hhhug000/HexaMouse/newpcb/HexaMouse.kicad_pcb

## KiCad design newpcb/HexaMouse.kicad_pcb (2026-09-28)

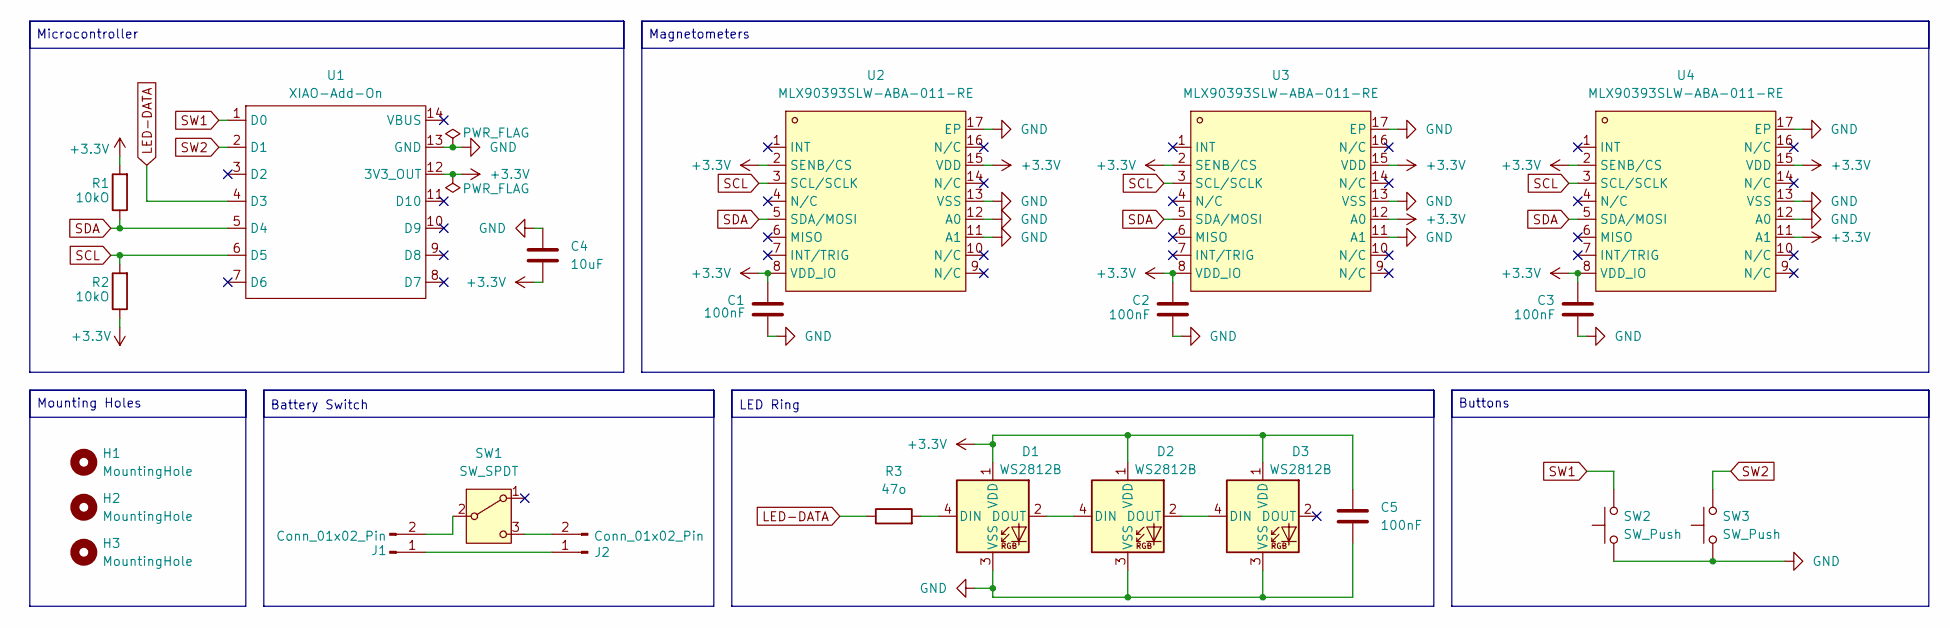
[picture p1: schematic HexaMouse.kicad_sch]

Parts:
C1, C2, C3, C5: 100nF; C_0603_1608Metric; LCSC C14663
C4: 10uF; C_0603_1608Metric; LCSC C96446
D1, D2, D3: WS2812B; LED_WS2812B_PLCC4_5.0x5.0mm_P3.2mm; LCSC C2761795
H1, H2, H3: MountingHole; MountingHole_3.2mm_M3
J1, J2: Conn_01x02_Pin; PinHeader_1x02_P2.54mm_Vertical
R1, R2: 10kO; R_0603_1608Metric; LCSC C25804
R3: 47o; R_0603_1608Metric; LCSC C23182
SW1: SW_SPDT; SW_SPDT_PCM12; LCSC C221841
SW2, SW3: SW_Push; SW_SPST_B3U-3000P-B; LCSC C4364471
U1: XIAO-Add-On; XIAO-14P-Add-On
U2, U3, U4: MLX90393SLW-ABA-011-RE; VQFN-16_L3.0-W3.0-P0.50-BL-EP1.7; MPN MLX90393SLW-ABA-011-RE; LCSC Part C2649492

Connections:
+3.3V: C1.1, C2.1, C3.1, C4.2, C5.1, D1.1 (VDD), D2.1 (VDD), D3.1 (VDD), R1.2, R2.1, U1.12 (3V3_OUT), U2.2 (SENB/CS), U2.8 (VDD_IO), U2.15 (VDD), U3.2 (SENB/CS), U3.8 (VDD_IO), U3.12 (A0), U3.15 (VDD), U4.2 (SENB/CS), U4.8 (VDD_IO), U4.11 (A1), U4.15 (VDD)
GND: C1.2, C2.2, C3.2, C4.1, C5.2, D1.3 (VSS), D2.3 (VSS), D3.3 (VSS), SW2.1, SW3.1, U1.13 (GND), U2.11 (A1), U2.12 (A0), U2.13 (VSS), U2.17 (EP), U3.11 (A1), U3.13 (VSS), U3.17 (EP), U4.12 (A0), U4.13 (VSS), U4.17 (EP)
LED-DATA: R3.1, U1.4 (D3)
unnamed: D1.4 (DIN), R3.2
unnamed: D1.2 (DOUT), D2.4 (DIN)
unnamed: D2.2 (DOUT), D3.4 (DIN)
unnamed: J1.1, J2.1
unnamed: J1.2, SW1.2 (B)
unnamed: J2.2, SW1.3 (C)
SCL: R2.2, U1.6 (D5), U2.3 (SCL/SCLK), U3.3 (SCL/SCLK), U4.3 (SCL/SCLK)
SDA: R1.1, U1.5 (D4), U2.5 (SDA/MOSI), U3.5 (SDA/MOSI), U4.5 (SDA/MOSI)
SW1: SW2.2, U1.1 (D0)
SW2: SW3.2, U1.2 (D1)

Notes on the sheet:
LED Ring
Battery Switch
Mounting Holes
Magnetometers
Buttons
Microcontroller

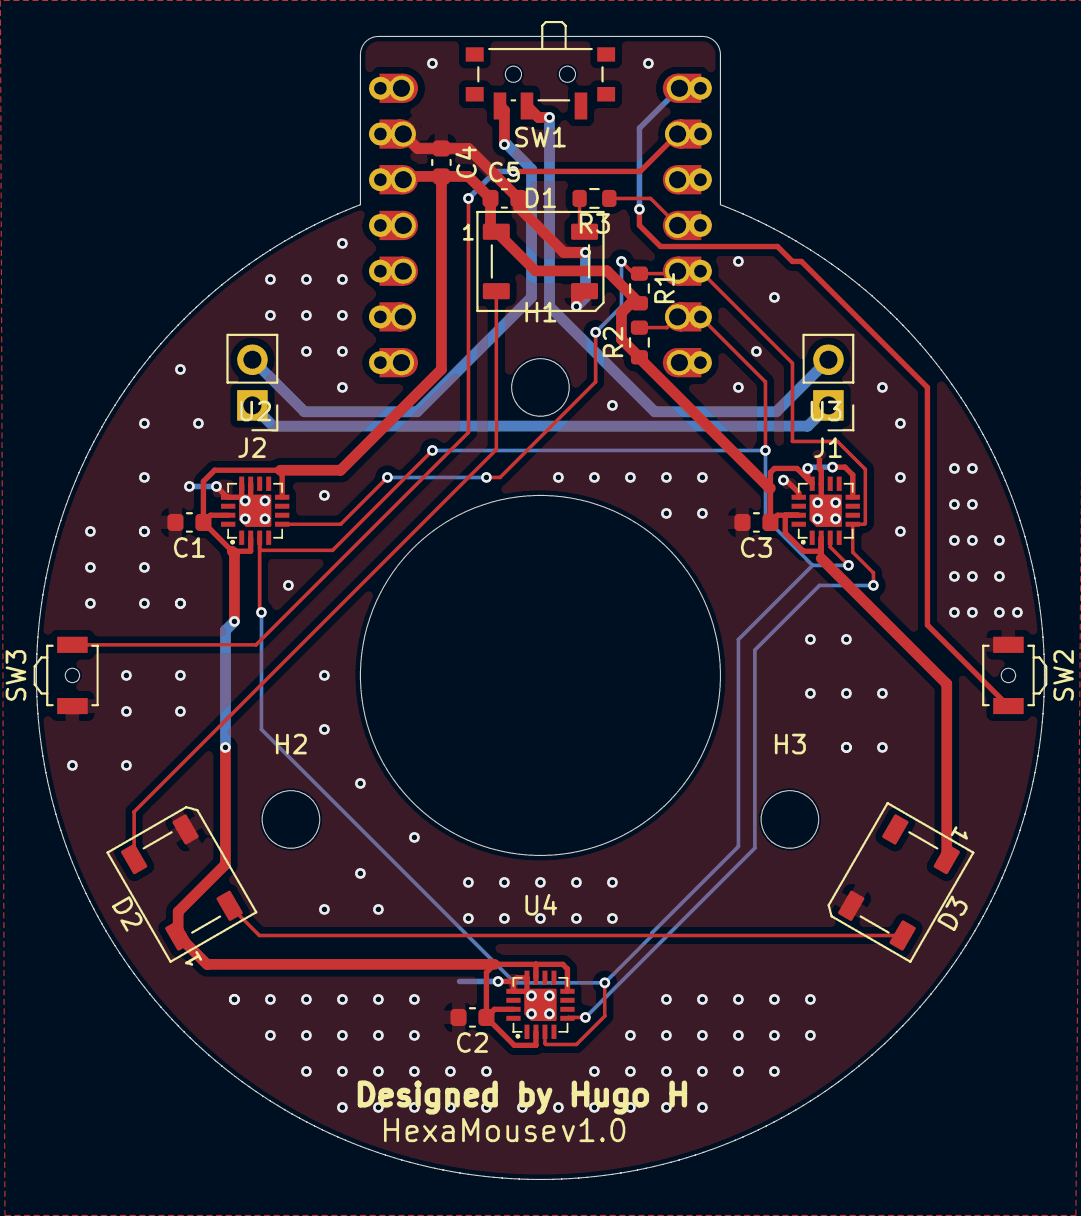
[picture p2: board newpcb/HexaMouse.kicad_pcb from above]

Board: 2 copper layers, 56.0 x 63.5 mm, 23 parts (1 on the bottom side), 13 nets.
