hhhug000/HexaMouse/pcb/HexaMouse.kicad_pcb

## KiCad design pcb/HexaMouse.kicad_pcb (2026-09-26)

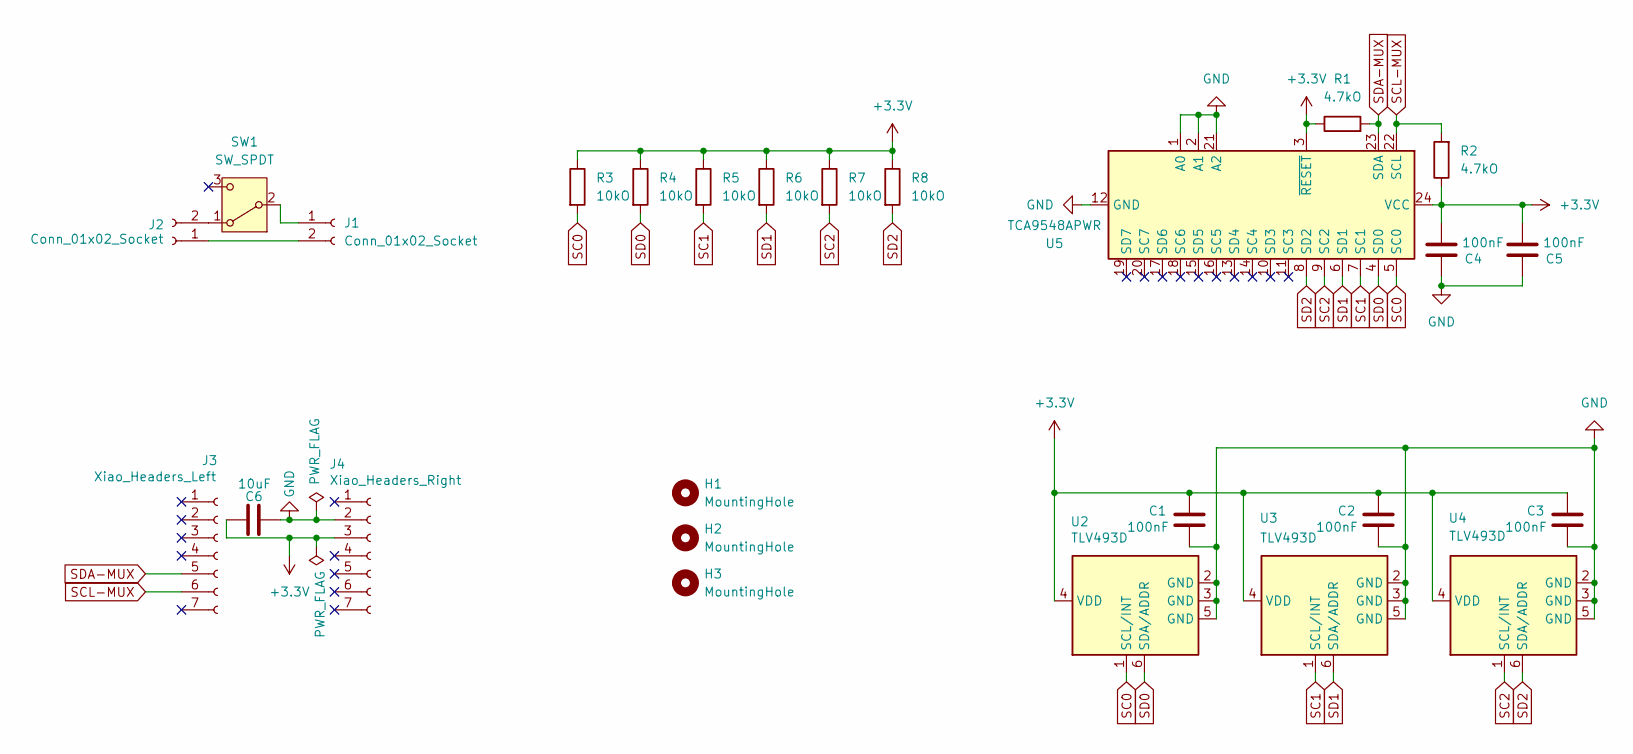
[picture p3: schematic HexaMouse.kicad_sch]

Parts:
C1, C2, C3, C4, C5: 100nF; C_0805_2012Metric; LCSC C1711
C6: 10uF; C_0805_2012Metric; LCSC C15850
H1, H2, H3: MountingHole; MountingHole_3.2mm_M3
J1, J2: Conn_01x02_Socket; JST_SH_SM02B-SRSS-TB_1x02-1MP_P1.00mm_Horizontal; LCSC C160402
J3: Xiao_Headers_Left; PinSocket_1x07_P2.54mm_Vertical_SMD_Pin1Left; LCSC C42379199
J4: Xiao_Headers_Right; PinSocket_1x07_P2.54mm_Vertical_SMD_Pin1Right; LCSC C42379199
R1, R2: 4.7kO; R_0805_2012Metric; LCSC C17673
R3, R4, R5, R6, R7, R8: 10kO; R_0805_2012Metric; LCSC C17414
SW1: SW_SPDT; SW_SPDT_PCM12; LCSC C221841
U2, U3, U4: TLV493D; SOT-23-6; LCSC C126688
U5: TCA9548APWR; TSSOP-24_4.4x7.8mm_P0.65mm; LCSC C130026

Connections:
+3.3V: C1.1, C2.1, C3.1, C4.2, C5.2, C6.2, J4.3, R1.1, R2.1, R3.1, R4.1, R5.1, R6.1, R7.1, R8.1, U2.4 (VDD), U3.4 (VDD), U4.4 (VDD), U5.3 (~RESET), U5.24 (VCC)
GND: C1.2, C2.2, C3.2, C4.1, C5.1, C6.1, J4.2, U2.2 (GND), U2.3 (GND), U2.5 (GND), U3.2 (GND), U3.3 (GND), U3.5 (GND), U4.2 (GND), U4.3 (GND), U4.5 (GND), U5.1 (A0), U5.2 (A1), U5.12 (GND), U5.21 (A2)
unnamed: J1.1, SW1.2 (B)
unnamed: J1.2, J2.1
unnamed: J2.2, SW1.1 (A)
SC0: R3.2, U2.1 (SCL/INT), U5.5 (SC0)
SC1: R5.2, U3.1 (SCL/INT), U5.7 (SC1)
SC2: R7.2, U4.1 (SCL/INT), U5.9 (SC2)
SCL-MUX: J3.6, R2.2, U5.22 (SCL)
SD0: R4.2, U2.6 (SDA/ADDR), U5.4 (SD0)
SD1: R6.2, U3.6 (SDA/ADDR), U5.6 (SD1)
SD2: R8.2, U4.6 (SDA/ADDR), U5.8 (SD2)
SDA-MUX: J3.5, R1.2, U5.23 (SDA)

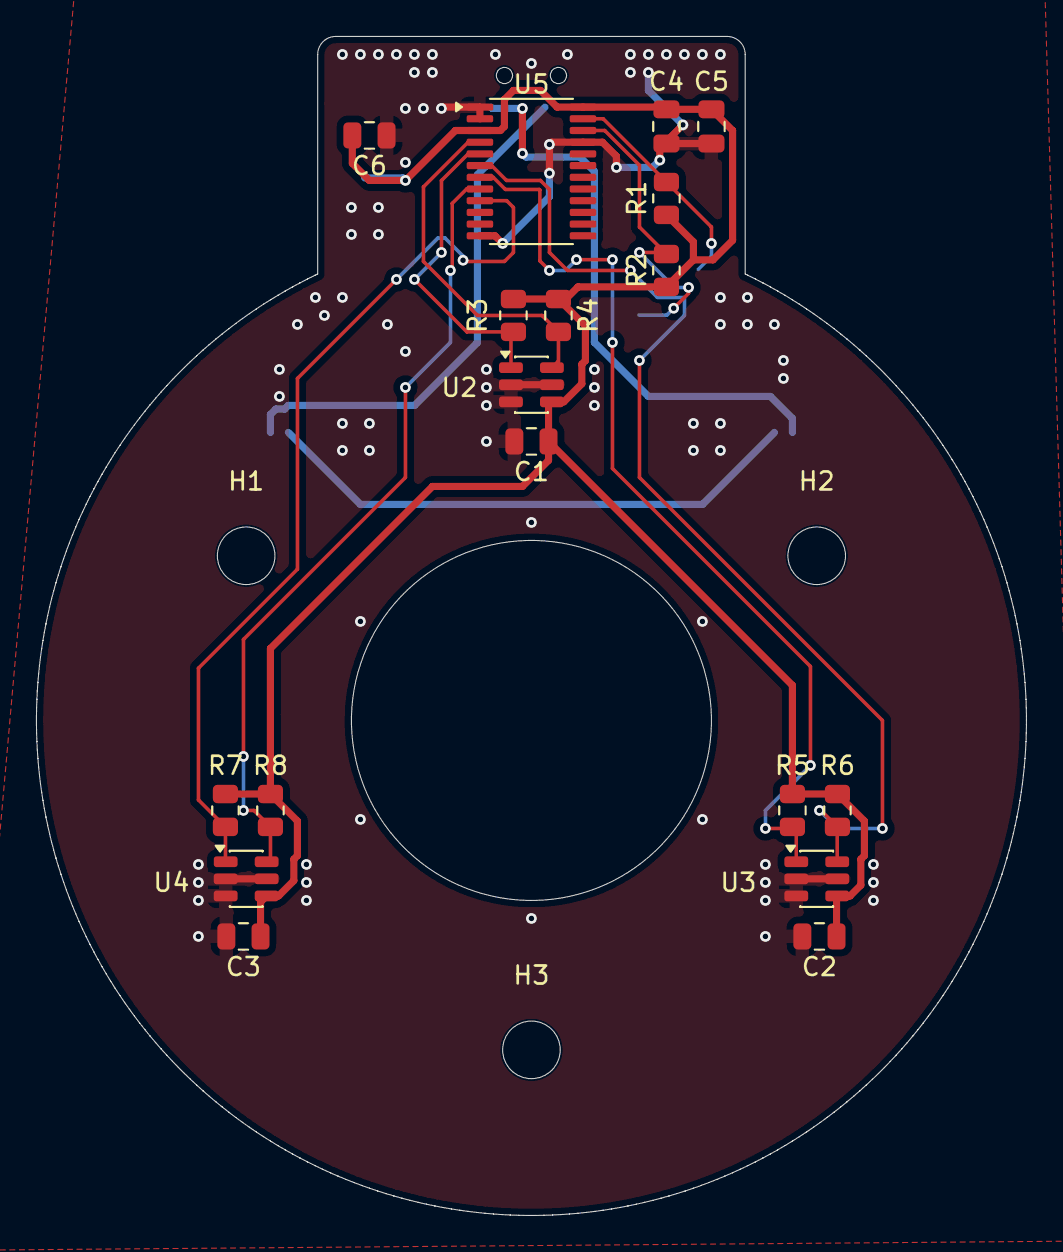
[picture p4: board pcb/HexaMouse.kicad_pcb from above]

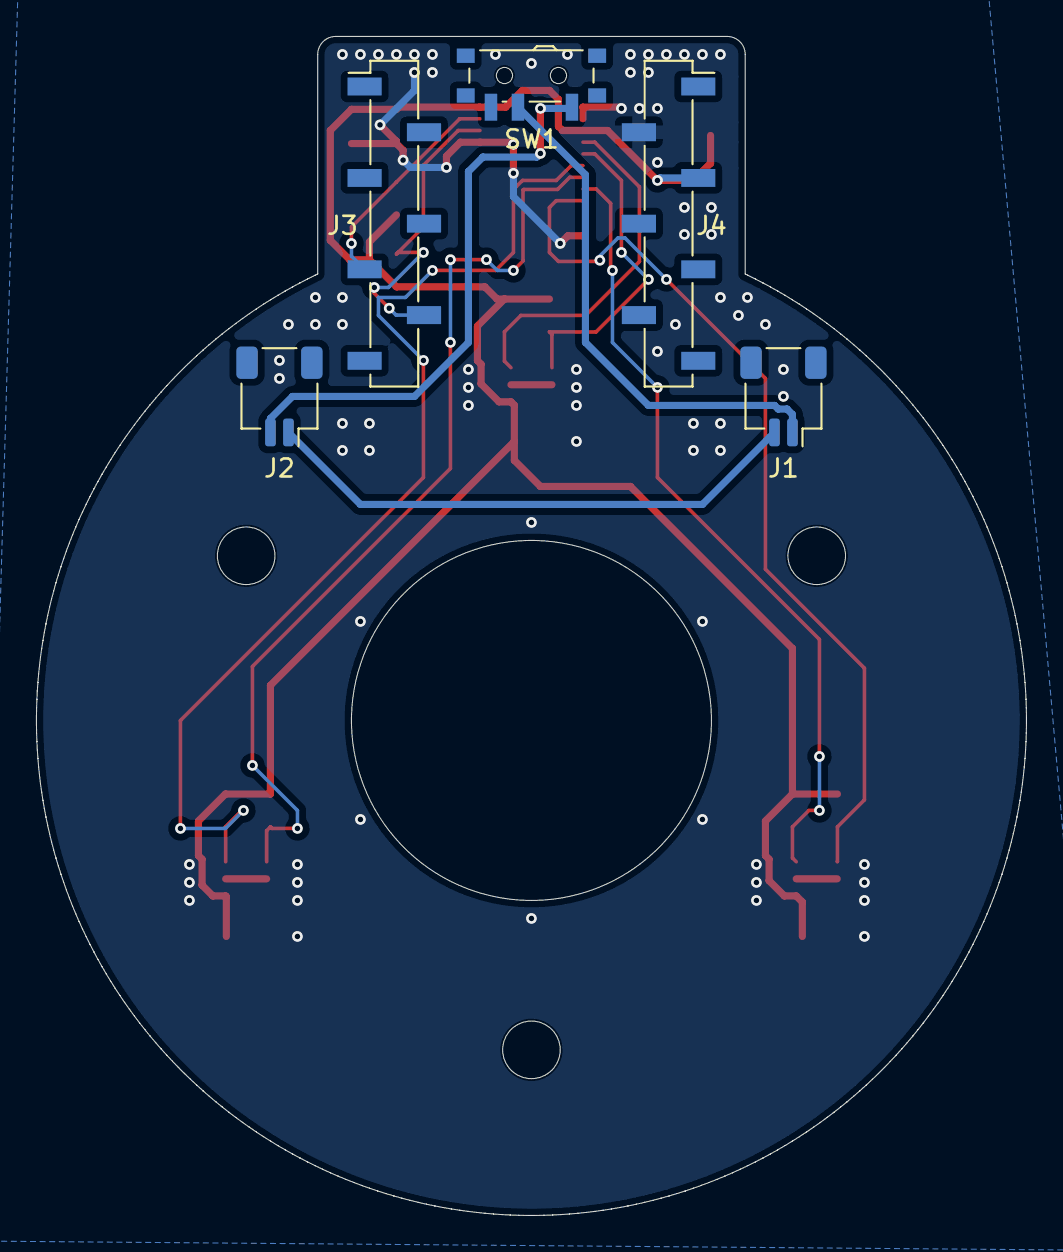
[picture p5: board pcb/HexaMouse.kicad_pcb from below]

Board: 2 copper layers, 55.0 x 65.5 mm, 26 parts (5 on the bottom side), 13 nets.
