hhhug000/HexaMouse/(commit log)

2026-09-19 Add kicad project and seeed studio xiao libs
    [HexaMouse.kicad_pcb, HexaMouse.kicad_sch]
2026-09-19 Added microcontroller board to schematic
    [HexaMouse.kicad_sch]
2026-09-19 magnetometers + i2c mux added to schematic
    [HexaMouse.kicad_sch]
2026-09-19 Added supporting hardware
    [HexaMouse.kicad_sch]
2026-09-20 Added more power caps and no connect flags
    [HexaMouse.kicad_sch]
2026-09-24 Swapped from MCU to pins so i can use headers instead
    [HexaMouse.kicad_sch]
2026-09-24 Started footprinting
    [HexaMouse.kicad_sch]
2026-09-25 Finished footprinting and added LCSC numbers
    [HexaMouse.kicad_sch]
2026-09-25 Start on PCB
    [HexaMouse.kicad_pcb]
2026-09-25 Added sensor sensitive area to footprint
    [HexaMouse.kicad_pcb]
2026-09-25 Fixed pcb shape and positioned pos sensitive components
    [HexaMouse.kicad_pcb]
2026-09-25 Swapped jst connector footprint, and positioned some more components
    [HexaMouse.kicad_pcb, HexaMouse.kicad_sch]
2026-09-25 Added and positioned mounting holes
    [HexaMouse.kicad_pcb, HexaMouse.kicad_sch]
2026-09-26 Positioned all capacitors
    [HexaMouse.kicad_pcb]
2026-09-26 Positioned the resistors
    [HexaMouse.kicad_pcb]
2026-09-26 Did pcb routing
    [HexaMouse.kicad_pcb]
2026-09-26 Did some ground stitching
    [HexaMouse.kicad_pcb]
2026-09-26 Fixed DRC issues
    [HexaMouse.kicad_pcb]
2026-09-26 Made power and ground traces wider
    [HexaMouse.kicad_pcb]
2026-09-27 Start on new pcb, schematic
    [HexaMouse.kicad_pcb, HexaMouse.kicad_sch]
2026-09-27 Added bulk decoupling cap
    [HexaMouse.kicad_sch]
2026-09-27 Added LEDs and Buttons to schematic
    ERC all clear so can go to pcb now
    [HexaMouse.kicad_sch]
2026-09-27 Did footprinting and lcsc
    [HexaMouse.kicad_sch]
2026-09-27 Added parts to pcb
    [HexaMouse.kicad_pcb]
2026-09-27 Basic pcb design start
    [HexaMouse.kicad_pcb]
2026-09-27 Positioned mounting holes
    [HexaMouse.kicad_pcb]
2026-09-28 Positioned LEDs
    [HexaMouse.kicad_pcb]
2026-09-28 Positioned Capacitors
    [HexaMouse.kicad_pcb]
2026-09-28 Resistor Positioning
    [HexaMouse.kicad_pcb]
2026-09-28 Added battery nets to power class
    [HexaMouse.kicad_pcb]
2026-09-28 Swapped battery nets
    [HexaMouse.kicad_pcb, HexaMouse.kicad_sch]
2026-09-28 Did some routing
    [HexaMouse.kicad_pcb]
2026-09-28 Solved some drc errors
    [HexaMouse.kicad_pcb]
2026-09-28 Started on some silkscreen
    [HexaMouse.kicad_pcb]
2026-10-01 Exported new pcb
2026-10-14 Remove old pcb
2026-11-08 New firmware and userspace driver
    Also onshape plugin!!!! rotation still messed up but positional quite good
